Brain-dll/MIDDLE-ALTITUDE-MAIN-SYSTEM-EMBEDDED-/README.md

# technofest-3000-telemetry
This repository was created to improve telemetry system of Ephemeris
