Brain-dll/MIDDLE-ALTITUDE-MAIN-SYSTEM-EMBEDDED-/HARDWARE/Mergen Telemetri + Ateşleme.brd

## EAGLE design HARDWARE/Mergen Telemetri + Ateşleme.brd (2021-08-31)

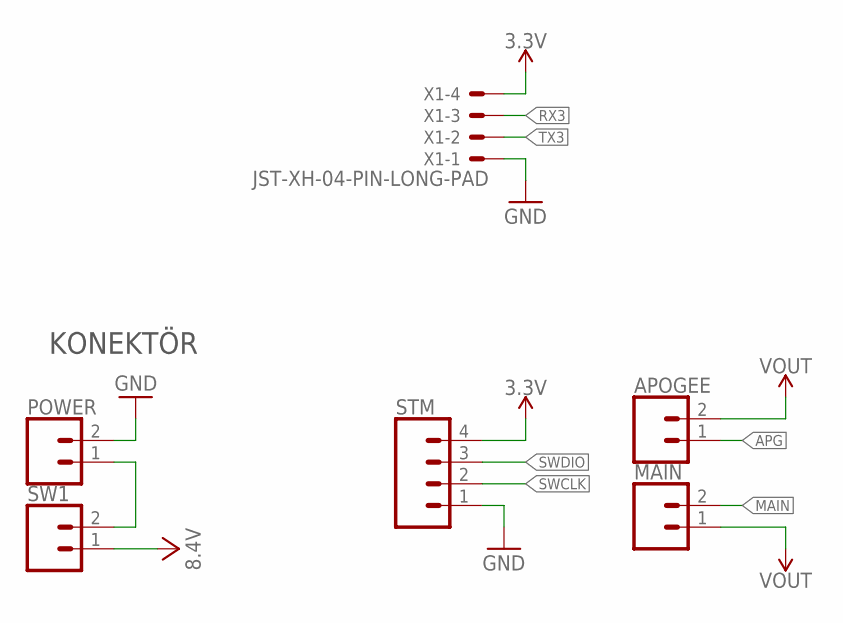
[picture p1: schematic Mergen Telemetri + Ateşleme.sch, sheet 1]

Parts:
APOGEE: CONN_023.5MM-NO_SILK; SCREWTERMINAL-3.5MM-2-NS
MAIN: CONN_023.5MM-NO_SILK; SCREWTERMINAL-3.5MM-2-NS
POWER: CONN_023.5MM-NO_SILK; SCREWTERMINAL-3.5MM-2-NS
STM: CONN_04; 1X04
SW1: CONN_023.5MM-NO_SILK; SCREWTERMINAL-3.5MM-2-NS
X1: JST-XH-04-PIN-LONG-PAD; JST-XH-04-PACKAGE-LONG-PAD

Connections:
3.3V: STM.4, X1.4; also elsewhere on the board
APG: APOGEE.1; also elsewhere on the board
GND: POWER.2, STM.1, X1.1; also elsewhere on the board
MAIN: MAIN.2; also elsewhere on the board
unnamed: POWER.1, SW1.2
RX3: X1.3; also elsewhere on the board
SWCLK: STM.2; also elsewhere on the board
SWDIO: STM.3; also elsewhere on the board
TX3: X1.2; also elsewhere on the board
VCC: SW1.1; also elsewhere on the board
VOUT: APOGEE.2, MAIN.1; also elsewhere on the board

Notes on the sheet:
KONEKTÖR

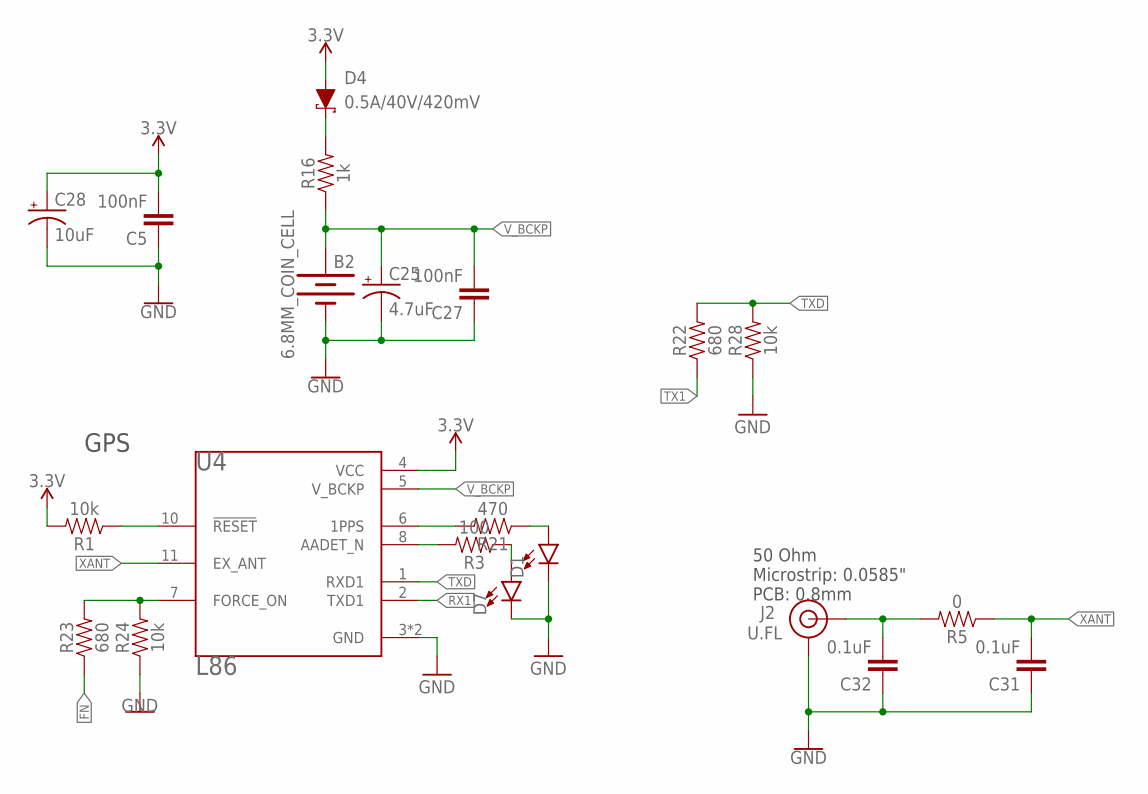
[picture p2: schematic Mergen Telemetri + Ateşleme.sch, sheet 2]

Parts:
B2: 6.8MM_COIN_CELL; BATTCON-6.8MM
C5, C27: 100nF; 0603
C25: 4.7uF; EIA3216
C28: 10uF; EIA3216
C31, C32: 0.1uF; 0603
D1, D7: LED0603; LED-0603
D4: 0.5A/40V/420mV; SOD-323
J2: U.FL
R1, R24, R28: 10k; 0603
R3: 100; 0603
R5: 0; 0603
R16: 1k; 0603
R21: 470; 0603
R22, R23: 680; 0603
U4: L86; XCVR_L86

Connections:
3.3V: C5.2, C28.+, D4.A, R1.2, U4.4 (VCC); also elsewhere on the board
FN: R23.1; also elsewhere on the board
GND: B2.-, C5.1, C25.-, C27.1, C28.-, C31.1, C32.1, D1.C, D7.C, J2.1 (GND), J2.2 (GND), R24.1, R28.1, U4.3 (GND), U4.12 (GND); also elsewhere on the board
unnamed: R1.1, U4.10 (!RESET)
unnamed: R21.2, U4.6 (1PPS)
unnamed: D1.A, R21.1
unnamed: D4.C, R16.2
unnamed: R3.2, U4.8 (AADET_N)
unnamed: D7.A, R3.1
unnamed: C32.2, J2.FEED (SIGNAL), R5.2
unnamed: R23.2, R24.2, U4.7 (FORCE_ON)
RX1: U4.2 (TXD1); also elsewhere on the board
TX1: R22.1; also elsewhere on the board
TXD: R22.2, R28.2, U4.1 (RXD1)
V_BCKP: B2.+, C25.+, C27.2, R16.1, U4.5 (V_BCKP)
XANT: C31.2, R5.1, U4.11 (EX_ANT)

Notes on the sheet:
GPS
50 Ohm Microstrip: 0.0585" PCB: 0.8mm

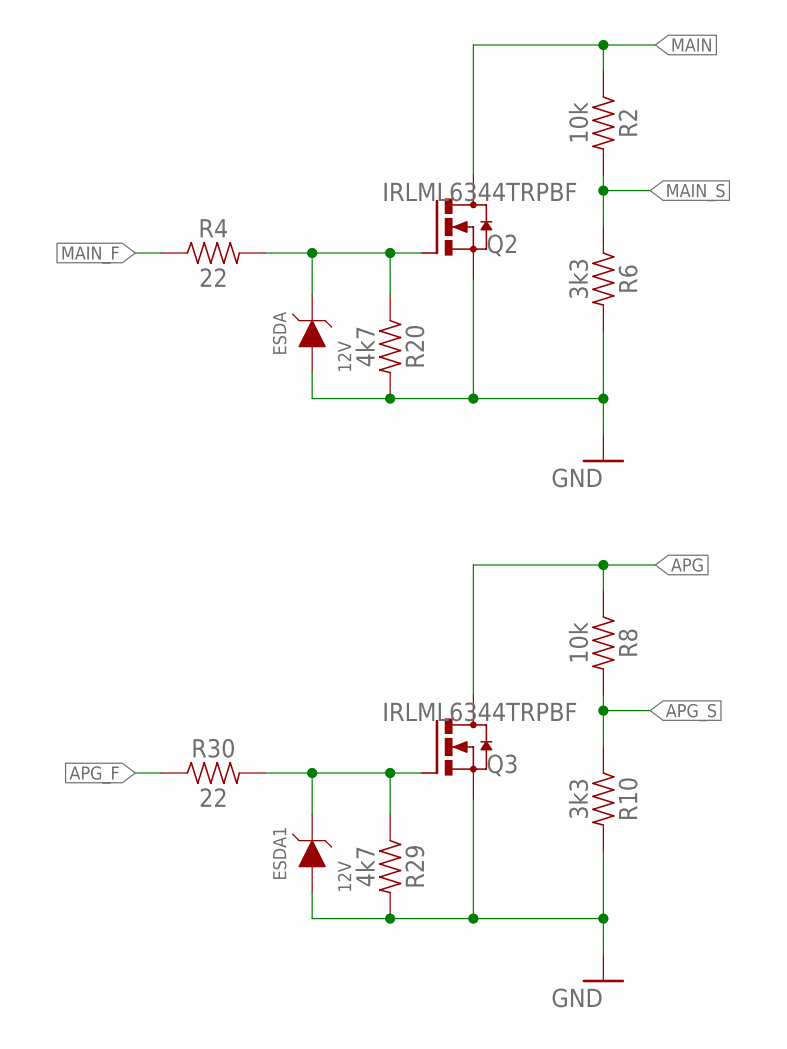
[picture p3: schematic Mergen Telemetri + Ateşleme.sch, sheet 3]

Parts:
ESDA, ESDA1: 12V; WE-TVSP_DO-214AC_UNIDIRECTIONAL
Q2, Q3: IRLML6344TRPBF; SOT23
R2, R8: 10k; 0603
R4, R30: 22; 0603
R6, R10: 3k3; 0603
R20, R29: 4k7; 0603

Connections:
APG: Q3.3 (D), R8.1; also elsewhere on the board
APG_F: R30.1; also elsewhere on the board
APG_S: R8.2, R10.1; also elsewhere on the board
GND: ESDA.2 (A), ESDA1.2 (A), Q2.2 (S), Q3.2 (S), R6.2, R10.2, R20.2, R29.2; also elsewhere on the board
MAIN: Q2.3 (D), R2.1; also elsewhere on the board
MAIN_F: R4.1; also elsewhere on the board
MAIN_S: R2.2, R6.1; also elsewhere on the board
unnamed: ESDA1.1 (C), Q3.1 (G), R29.1, R30.2
unnamed: ESDA.1 (C), Q2.1 (G), R4.2, R20.1

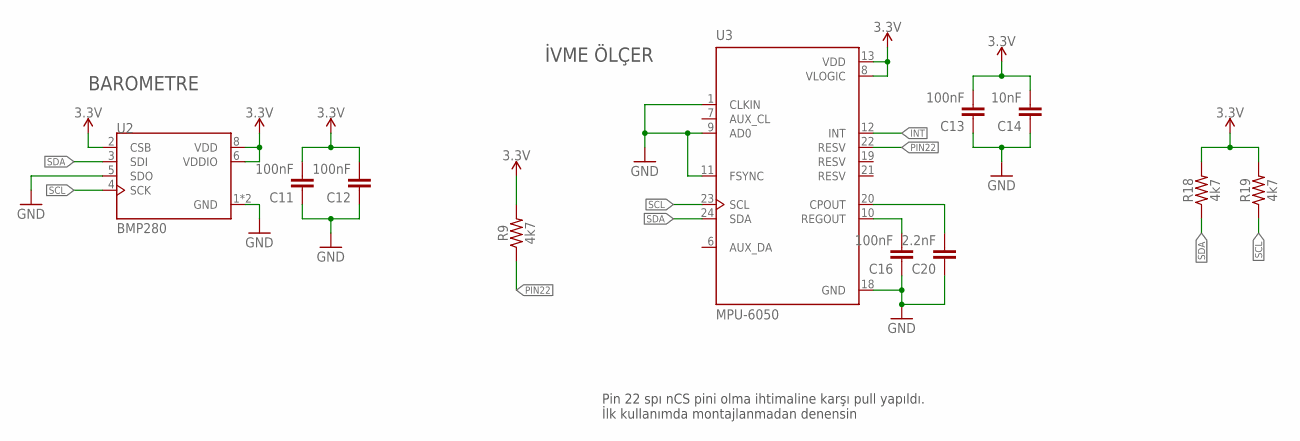
[picture p4: schematic Mergen Telemetri + Ateşleme.sch, sheet 4]

Parts:
C11, C12, C13, C16: 100nF; 0603
C14: 10nF; 0603
C20: 2.2nF; 0603
R9, R18, R19: 4k7; 0603
U2: BMP280; XDCR_BMP280
U3: MPU-6050; QFN50P400X400X95-24N

Connections:
3.3V: C11.2, C12.2, C13.2, C14.2, R9.2, R18.2, R19.2, U2.2 (CSB), U2.6 (VDDIO), U2.8 (VDD), U3.8 (VLOGIC), U3.13 (VDD); also elsewhere on the board
GND: C11.1, C12.1, C13.1, C14.1, C16.1, C20.1, U2.1 (GND), U2.5 (SDO), U2.7 (GND), U3.1 (CLKIN), U3.9 (AD0), U3.11 (FSYNC), U3.18 (GND); also elsewhere on the board
INT: U3.12 (INT); also elsewhere on the board
unnamed: C16.2, U3.10 (REGOUT)
unnamed: C20.2, U3.20 (CPOUT)
PIN22: R9.1, U3.22 (RESV)
SCL: R19.1, U2.4 (SCK), U3.23 (SCL); also elsewhere on the board
SDA: R18.1, U2.3 (SDI), U3.24 (SDA); also elsewhere on the board

Notes on the sheet:
İVME ÖLÇER
BAROMETRE
Pin 22 spı nCS pini olma ihtimaline karşı pull yapıldı. İlk kullanımda montajlanmadan denensin

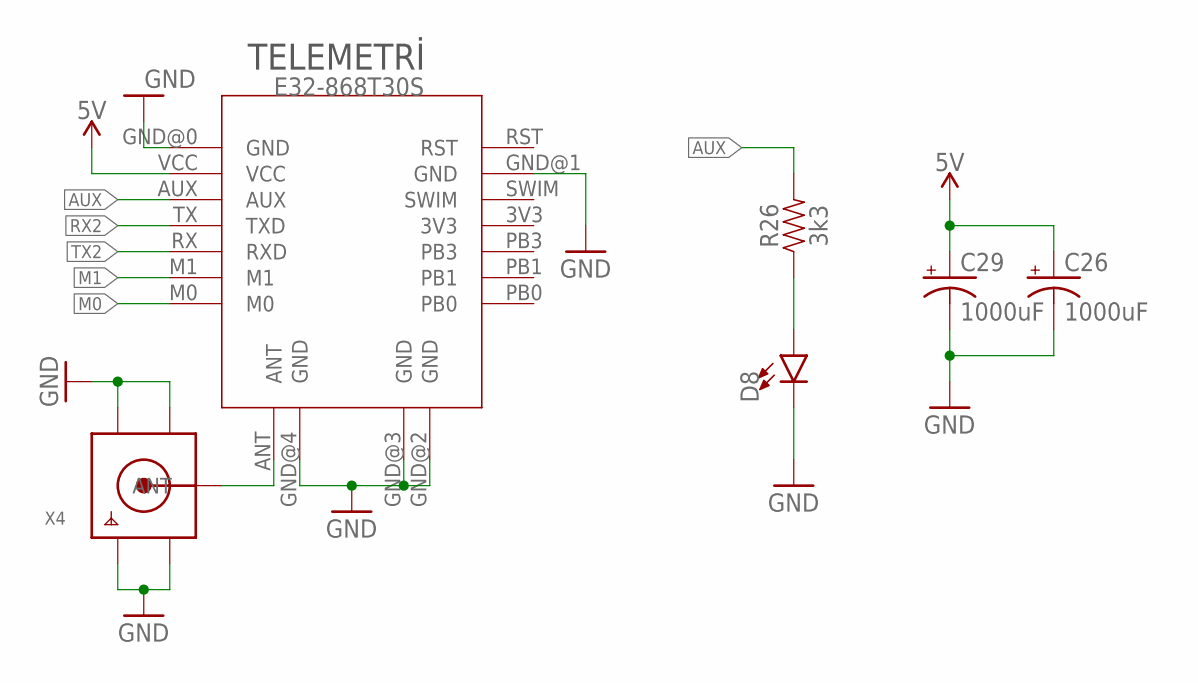
[picture p5: schematic Mergen Telemetri + Ateşleme.sch, sheet 5]

Parts:
C26, C29: 1000uF; 150CLZ-1010
D8: LED0603; LED-0603
R26: 3k3; 0603
U5: E32-868T30S
X4: SMACONNECTOR; SMA90_DIP

Connections:
5V: C26.+, C29.+, U5.VCC; also elsewhere on the board
AUX: R26.2, U5.AUX; also elsewhere on the board
GND: C26.-, C29.-, D8.C, U5.GND@0 (GND), U5.GND@1 (GND), U5.GND@2 (GND), U5.GND@3 (GND), U5.GND@4 (GND), X4.GND1, X4.GND2, X4.GND3, X4.GND4; also elsewhere on the board
M0: U5.M0; also elsewhere on the board
M1: U5.M1; also elsewhere on the board
unnamed: U5.ANT, X4.ANTENNA (ANT)
unnamed: D8.A, R26.1
RX2: U5.TX (TXD); also elsewhere on the board
TX2: U5.RX (RXD); also elsewhere on the board

Notes on the sheet:
TELEMETRİ

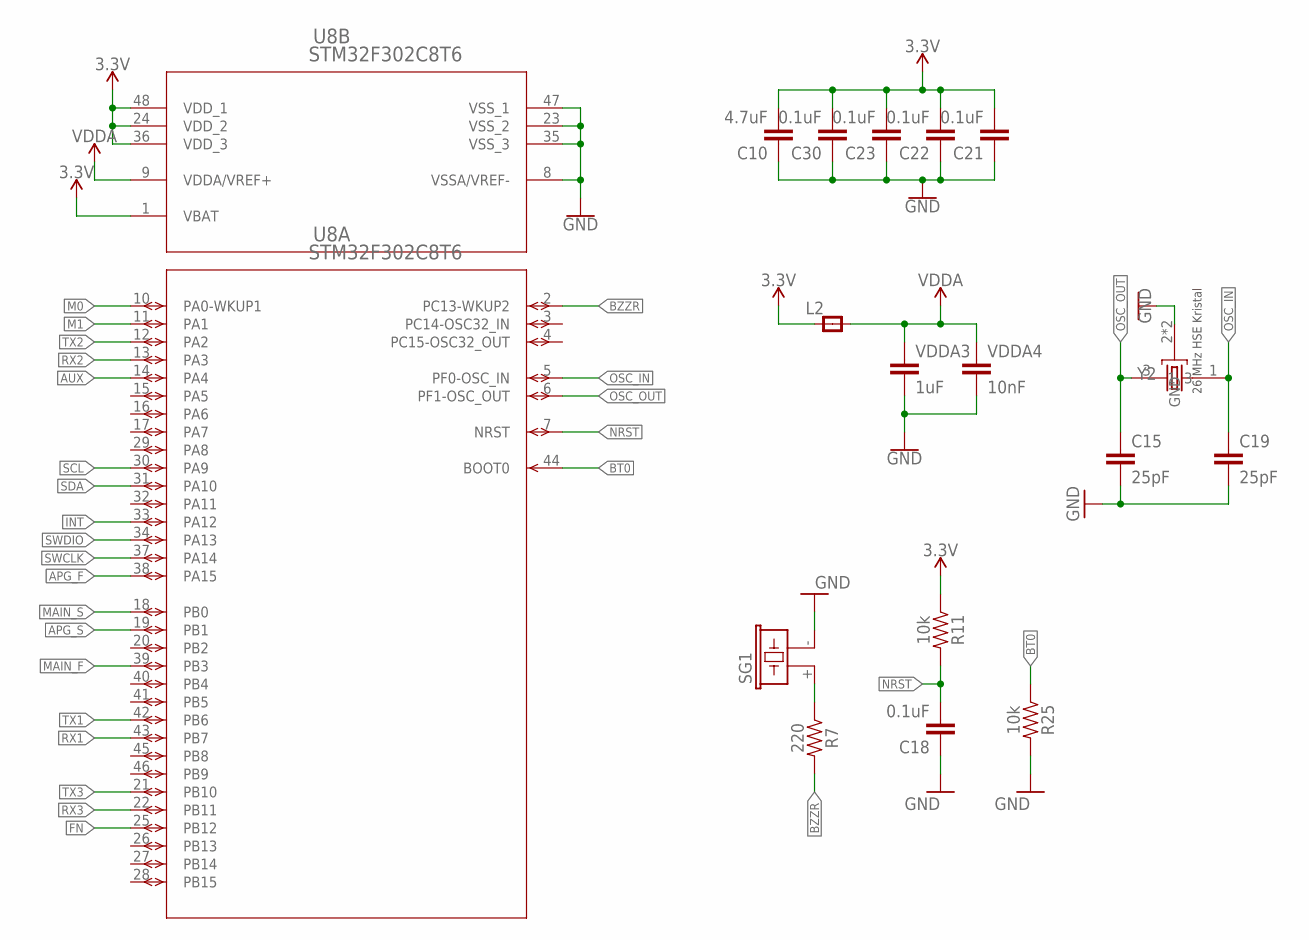
[picture p6: schematic Mergen Telemetri + Ateşleme.sch, sheet 6]

Parts:
C10: 4.7uF; 0603
C15, C19: 25pF; 0603
C18, C21, C22, C23, C30: 0.1uF; 0603
L2: RC-MASTER-SMD_FB_0805MP; RC-MASTER-SMD_L0805MP
R7: 220; 0603
R11, R25: 10k; 0603
SG1: F/CM12P
U8: STM32F302C8T6; LQFP48-7X7MM
VDDA3: 1uF; 0603
VDDA4: 10nF; 0603
Y2: ABM3B-26.000MHZ-10-1-U-T; OSCCC500X320X110-4N

Connections:
3.3V: C10.2, C21.2, C22.2, C23.2, C30.2, L2.1, R11.1, U8.1 (VBAT), U8.24 (VDD_2), U8.36 (VDD_3), U8.48 (VDD_1); also elsewhere on the board
APG_F: U8.38 (PA15); also elsewhere on the board
APG_S: U8.19 (PB1); also elsewhere on the board
AUX: U8.14 (PA4); also elsewhere on the board
BT0: R25.1, U8.44 (BOOT0)
BZZR: R7.2, U8.2 (PC13-WKUP2)
FN: U8.25 (PB12); also elsewhere on the board
GND: C10.1, C15.2, C18.1, C19.2, C21.1, C22.1, C23.1, C30.1, R25.2, SG1.- (2), U8.8 (VSSA/VREF-), U8.23 (VSS_2), U8.35 (VSS_3), U8.47 (VSS_1), VDDA3.2, VDDA4.2, Y2.2 (GND), Y2.4 (GND); also elsewhere on the board
INT: U8.33 (PA12); also elsewhere on the board
M0: U8.10 (PA0-WKUP1); also elsewhere on the board
M1: U8.11 (PA1); also elsewhere on the board
MAIN_F: U8.39 (PB3); also elsewhere on the board
MAIN_S: U8.18 (PB0); also elsewhere on the board
unnamed: R7.1, SG1.+ (1)
NRST: C18.2, R11.2, U8.7 (NRST)
OSC_IN: C19.1, U8.5 (PF0-OSC_IN), Y2.1
OSC_OUT: C15.1, U8.6 (PF1-OSC_OUT), Y2.3
RX1: U8.43 (PB7); also elsewhere on the board
RX2: U8.13 (PA3); also elsewhere on the board
RX3: U8.22 (PB11); also elsewhere on the board
SCL: U8.30 (PA9); also elsewhere on the board
SDA: U8.31 (PA10); also elsewhere on the board
SWCLK: U8.37 (PA14); also elsewhere on the board
SWDIO: U8.34 (PA13); also elsewhere on the board
TX1: U8.42 (PB6); also elsewhere on the board
TX2: U8.12 (PA2); also elsewhere on the board
TX3: U8.21 (PB10); also elsewhere on the board
VDDA: L2.2, U8.9 (VDDA/VREF+), VDDA3.1, VDDA4.1

Notes on the sheet:
26 MHz HSE Kristal

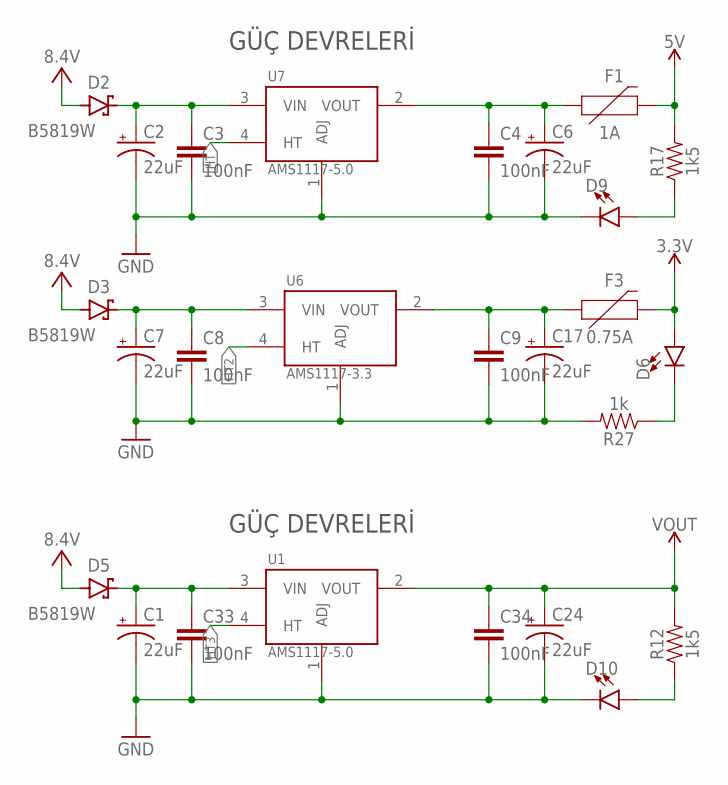
[picture p7: schematic Mergen Telemetri + Ateşleme.sch, sheet 7]

Parts:
C1, C2, C6, C7, C17, C24: 22uF; EIA3528
C3, C4, C8, C9, C33, C34: 100nF; 0603
D2, D3, D5: B5819W; SODFL3718X115
D6, D9, D10: LED0603; LED-0603
F1: 1A; 1206
F3: 0.75A; 1206
R12, R17: 1k5; 0603
R27: 1k; 0603
U1, U7: AMS1117-5.0; SOT229P700X180-4N
U6: AMS1117-3.3; SOT229P700X180-4N

Connections:
3.3V: D6.A, F3.2; also elsewhere on the board
5V: F1.2, R17.2; also elsewhere on the board
GND: C1.C (-), C2.C (-), C3.2, C4.2, C6.C (-), C7.C (-), C8.2, C9.2, C17.C (-), C24.C (-), C33.2, C34.2, D9.C, D10.C, R27.2, U1.1 (ADJ), U6.1 (ADJ), U7.1 (ADJ); also elsewhere on the board
HT: U7.4 (HT)
HT2: U6.4 (HT)
HT3: U1.4 (HT)
unnamed: C2.A (+), C3.1, D2.1 (C), U7.3 (VIN)
unnamed: C7.A (+), C8.1, D3.1 (C), U6.3 (VIN)
unnamed: C4.1, C6.A (+), F1.1, U7.2 (VOUT)
unnamed: C9.1, C17.A (+), F3.1, U6.2 (VOUT)
unnamed: D9.A, R17.1
unnamed: D6.C, R27.1
unnamed: C1.A (+), C33.1, D5.1 (C), U1.3 (VIN)
unnamed: D10.A, R12.1
VCC: D2.2 (A), D3.2 (A), D5.2 (A); also elsewhere on the board
VOUT: C24.A (+), C34.1, R12.2, U1.2 (VOUT); also elsewhere on the board

Notes on the sheet:
GÜÇ DEVRELERİ

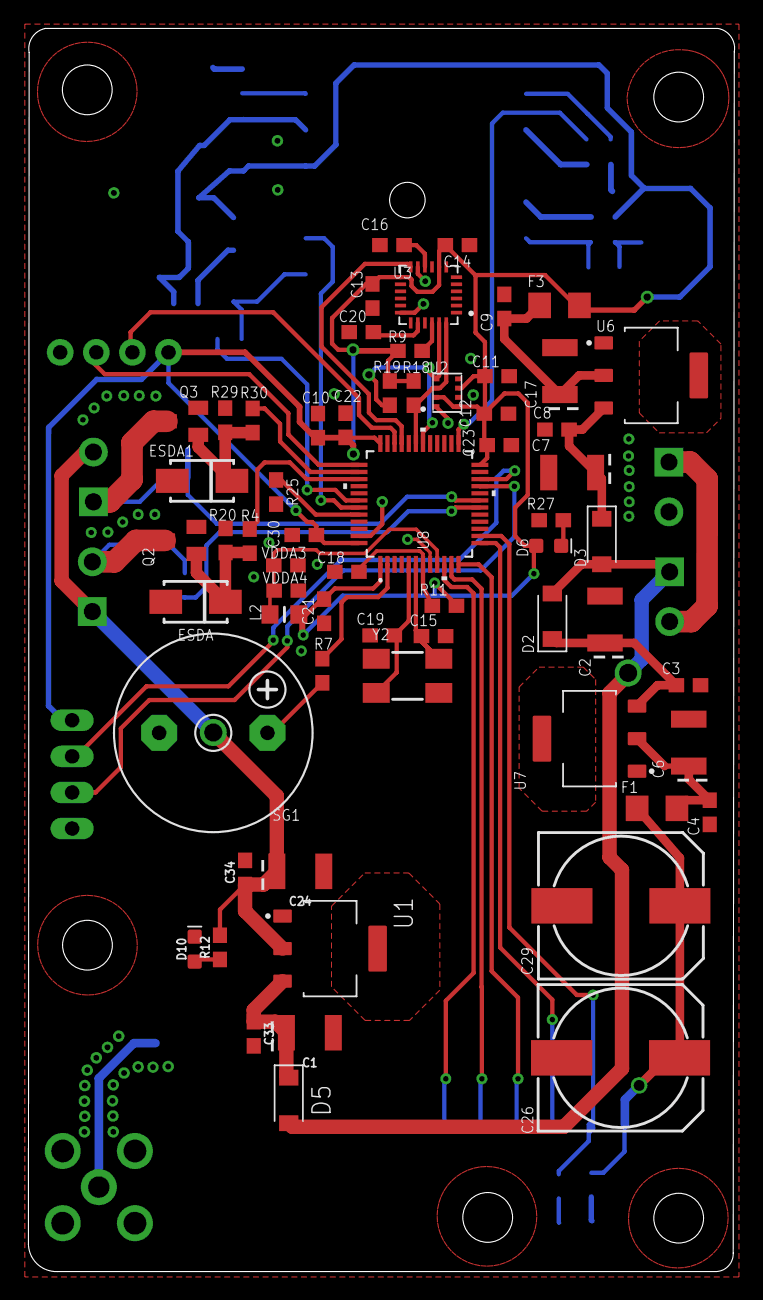
[picture p8: board Mergen Telemetri + Ateşleme.brd from above]

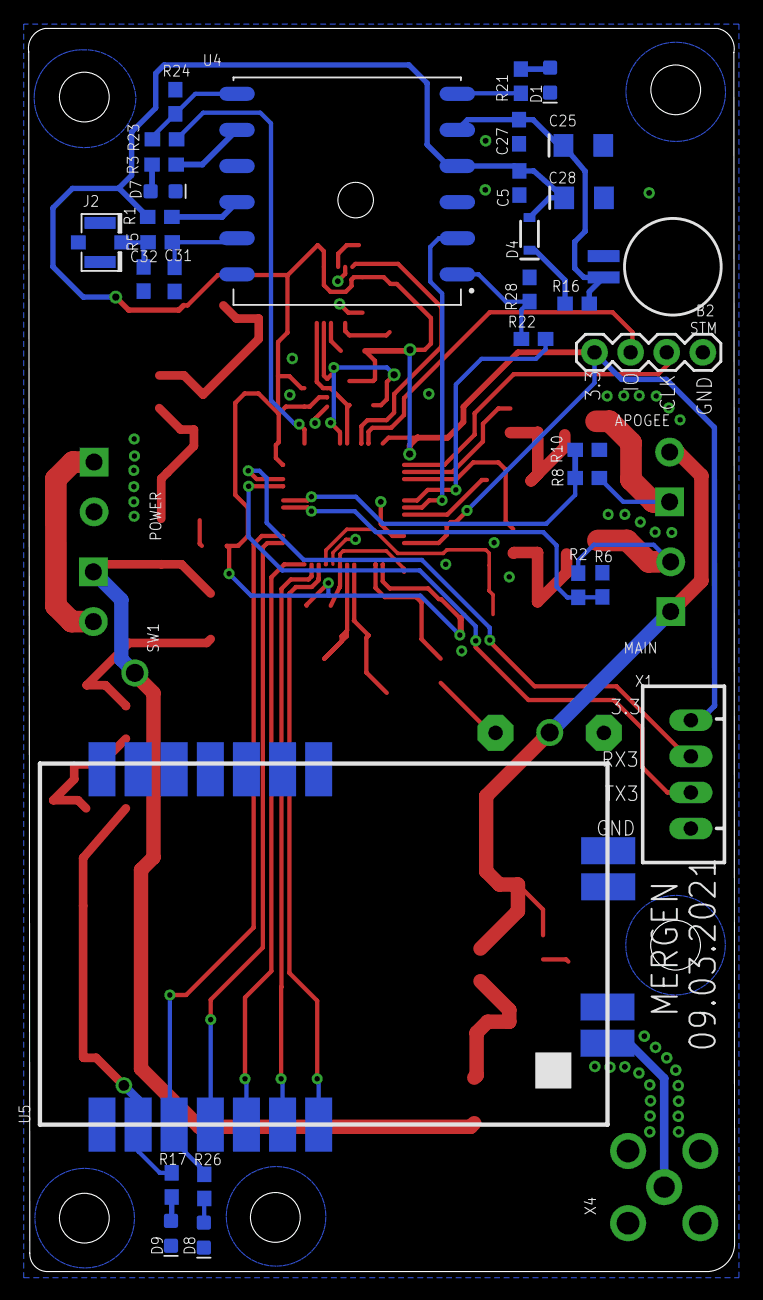
[picture p9: board Mergen Telemetri + Ateşleme.brd from below]

Board: 2 copper layers, 49.7 x 87.5 mm, 99 parts (37 on the bottom side), 60 nets.
