Brain-dll/MIDDLE-ALTITUDE-MAIN-SYSTEM-EMBEDDED-/SOFTWARE/Core/Src/main.c

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
/* Includes ------------------------------------------------------------------*/
#include "main.h"

/* USER CODE BEGIN Includes */
#include "BME280.h"
#include "MPU-6050.h"
#include "math.h"
#include "string.h"
#include "stdio.h"
#include <stdlib.h>
/* USER CODE END Includes */

/* USER CODE BEGIN PD */
#define t 200
#define PI 3.14159265358979323846
#define ACC_l 2.5  // kalkisi anlamak icin gerekli ivme eşigi (pozitif olmali)***

// değişebilir offset değerleri
#define gyroOffsetX -0.22
#define gyroOffsetY  1.11
#define gyroOffsetZ -5.64
#define acceOffsetX  0.38
#define acceOffsetY -1.93

float AcceX = .0, AcceY = .0, AcceZ = .0;
float GyroX = .0, GyroY = .0, GyroZ = .0;
float AcceAngleX = .0, AcceAngleY = .0, GyroAngleX = .0, GyroAngleY = .0, GyroAngleZ = .0;
float GyroBound = 3.0;
float roll = .0, pitch = .0;

float maxPositiveRoll = 0;
float maxNegativeRoll = -79.0;
float maxPositivePitch = 82.0;
float maxNegativePitch = -76.0;


uint32_t CurrentTime = 0, PreviousTime = 0;
float ElapsedTime = .0;

float calcoor(float x);
void LORA_READ_PARAMETER(void);
void LORA_CONFG(uint8_t ADDH, uint8_t ADDL, uint8_t CHN, uint8_t MODE);
void ReadGyroAcceValues(void);
void ReadAccerollpitchValues(void);

float A = 0, T, P, V;
float BM_V[6] = {0}, BM_A[6] = {0};
float MPU_ACC_Z[6] = {0}, roll, pitch, rollFilter, pitchFilter;
float lat;
float lng;

int tim1 = 0, tim2 = 0, dif = 0;
int time = 0;

uint8_t BM_S = 0;
uint8_t apogee = 0, alt_l = 0;
uint8_t MPU_FAIL = 0, MPU = 0, MPU_ACC_S = 0, BME = 0;
uint8_t GGA = 0;
uint8_t k = 0;
uint8_t v = 0;
uint8_t warning = 0;
uint8_t apg = 0;
uint8_t mn = 0;
uint8_t MPU_RP = 0;
uint8_t counter_Tel = 0;
extern uint8_t gyro;

uint8_t runningSize = 5;
float gyroArrayX[5];
float gyroArrayY[5];
float gyroArrayZ[5];
uint8_t countRunning = 1;
float totalGyroX = 0.0;
float totalGyroY = 0.0;
float totalGyroZ = 0.0;
uint8_t startRunning = 0;

uint8_t runningSizeA = 5;
float AcceArrayX[5];
float AcceArrayY[5];
float AcceArrayZ[5];
uint8_t countRunningA = 1;
float totalAcceX = 0.0;
float totalAcceY = 0.0;
float totalAcceZ = 0.0;
uint8_t startRunningA = 0;

char RX_BUF[512];
char GPGGA[75];
char LAT[9];
char LONG[10];
char TIME[10];
char COOR[60];

uint8_t RF = 0;
//uint8_t ADDH = 0x6;
//uint8_t ADDL = 0x4A;
//uint8_t CHN = 0xA;
//uint8_t MODE = 1;

//char LORA_ADRESS[3] = {0};

/*  EPHEMERISH RECEIVER CONFGURATION  */
uint8_t ADDH = 0x8;
uint8_t ADDL = 0x2A;
uint8_t CHN = 0x2;
uint8_t MODE = 1;


/*  EPHEMERISH SENDER CONFGURATION  */
uint8_t SENDER_ADDH = 0x6;
uint8_t SENDER_ADDL = 0x4A;
uint8_t SENDER_CHN = 0xA;


///*  PAYLOAD RECEIVER CONFGURATION  */
//uint8_t ADDH = 0x9;
//uint8_t ADDL = 0x3A;
//uint8_t CHN = 0x3;
//uint8_t MODE = 1;
//
//
///*  PAYLOAD SENDER CONFGURATION  */
//uint8_t SENDER_ADDH = 0x6;
//uint8_t SENDER_ADDL = 0x4A;
//uint8_t SENDER_CHN = 0xA;


/* USER CODE END PD */

I2C_HandleTypeDef hi2c2;

TIM_HandleTypeDef htim1;
TIM_HandleTypeDef htim2;
TIM_HandleTypeDef htim6;
TIM_HandleTypeDef htim15;

UART_HandleTypeDef huart1;
UART_HandleTypeDef huart2;
UART_HandleTypeDef huart3;
DMA_HandleTypeDef hdma_usart1_rx;

/* USER CODE BEGIN PV */
void HAL_UART_RxCpltCallback(UART_HandleTypeDef *huart) {
	for (uint16_t i = 0; i < 512; i++) {

		if (RX_BUF[i] == '$' && RX_BUF[i + 1] == 'G' && RX_BUF[i + 2] == 'P'
				&& RX_BUF[i + 3] == 'G' && RX_BUF[i + 4] == 'G'
				&& RX_BUF[i + 5] == 'A' && RX_BUF[i + 6] == ',') {
			for (uint8_t n = 0; n < sizeof(GPGGA); n++) {
				GPGGA[n] = RX_BUF[i + n];
				if (n > 5 && GPGGA[n - 1] == '\r' && GPGGA[n] == '\n') {
					GGA = 1;
					break;
				}
			}
			if (GGA == 1) {

				uint8_t v = 0, pos1 = 0, pos2 = 0, pos3 = 0, pos4 = 0, pos5 = 0,
						ok1 = 0, ok2 = 0, ok3 = 0, ok4 = 0;
				for (uint8_t n = 0; n < sizeof(GPGGA); n++) {
					if (GPGGA[n] == ',')
						v++;
					if (v == 1 && ok1 == 0) {
						pos1 = n;
						ok1 = 1;
					}
					if (v == 2 && ok2 == 0) {
						pos2 = n;
						for (uint8_t count = 0; count < pos2 - pos1; count++)
							TIME[count] = GPGGA[pos1 + count + 1];
						ok2 = 1;
					}
					if (v == 3 && ok3 == 0) {
						pos3 = n;
						for (uint8_t count = 0; count < pos3 - pos2; count++)
							LAT[count] = GPGGA[pos2 + count + 1];
						ok3 = 1;
					}
					if (v == 4 && ok4 == 0) {
						pos4 = n;
						ok4 = 1;
					}
					if (v == 5) {
						pos5 = n;
						for (uint8_t count2 = 0; count2 < pos5 - pos4; count2++)
							LONG[count2] = GPGGA[pos4 + count2 + 1];

						strcpy(TIME, TIME);
						strcpy(LAT, LAT);
						strcpy(LONG, LONG);
						time = atof(TIME);
						time = time % 100;
						lat = calcoor(atof(LAT));
						lng = calcoor(atof(LONG));
						/*sprintf(COOR, ":%2.7f:%2.7f\n", lat, lng);
						 HAL_UART_Transmit(&huart3, (uint8_t*) COOR,
						 sizeof(COOR), 1000);*/
						for (uint16_t c = 0; c < sizeof(RX_BUF); c++)
							RX_BUF[c] = '\0';
						for (uint16_t c = 0; c < sizeof(GPGGA); c++)
							GPGGA[c] = '\0';
						for (uint16_t c = 0; c < sizeof(LAT); c++)
							LAT[c] = '\0';
						for (uint16_t c = 0; c < sizeof(LONG); c++)
							LONG[c] = '\0';
						for (uint16_t c = 0; c < sizeof(TIME); c++)
							TIME[c] = '\0';
						break;
					}
				}
			}
		}
	}
	//HAL_UART_Receive_DMA(&huart1, (uint8_t *)RX_BUF, 512);
}
/* USER CODE END PV */

void SystemClock_Config(void);
static void MX_GPIO_Init(void);
static void MX_DMA_Init(void);
static void MX_I2C2_Init(void);
static void MX_USART1_UART_Init(void);
static void MX_USART2_UART_Init(void);
static void MX_USART3_UART_Init(void);
static void MX_TIM2_Init(void);
static void MX_TIM6_Init(void);
static void MX_TIM1_Init(void);
static void MX_TIM15_Init(void);
/* USER CODE BEGIN PFP */
//extern uint32_t SystemCoreClock;
//uint32_t Systemlock = 0;
/* USER CODE END PFP */

/**
  * @brief  The application entry point.
  * @retval int
  */
int main(void)
{
  /* MCU Configuration--------------------------------------------------------*/

  /* Reset of all peripherals, Initializes the Flash interface and the Systick. */
   HAL_Init();

  /* Configure the system clock */
  SystemClock_Config();

  /* Initialize all configured peripherals */
  MX_GPIO_Init();
  MX_DMA_Init();
  MX_I2C2_Init();
  MX_USART1_UART_Init();
  MX_USART2_UART_Init();
  MX_USART3_UART_Init();
  MX_TIM2_Init();
  MX_TIM6_Init();
  MX_TIM1_Init();
  MX_TIM15_Init();
  /* USER CODE BEGIN 2 */
	/*HAL_GPIO_WritePin(GPIOA, GPIO_PIN_0, SET);
	HAL_GPIO_WritePin(GPIOA, GPIO_PIN_1, SET);*/
	LORA_READ_PARAMETER();  // don't make commit all of these two functions
	LORA_CONFG(0x6, 0x4A, 0xA, 1);   // HIGH ADDRESS, LOW ADDRESS, CHANNEL, MODE (0 : TRANSPARENT, 1 : FIXED)

	BME280_Init();
	MPU6050_Init();

	enum device {
		Ephemerish, Payload
	} dev_ID;
	dev_ID = Ephemerish;
	//dev_ID = Payload;

	enum rocket {
		Rail, Launch, Burnout, Apogee, Descent, Main, Recovery
	};
	enum rocket EPHEMERISH;

	for (uint8_t i = 0; i < 12; i++) {
		HAL_GPIO_TogglePin(GPIOC, GPIO_PIN_13);
		HAL_Delay(50);
	}
	HAL_TIM_Base_Start_IT(&htim2);
	if (MPU_FAIL == 0) {
		EPHEMERISH = Rail;
		//EPHEMERISH = Apogee;
		HAL_TIM_Base_Start_IT(&htim6);
	} else if (MPU_FAIL == 1) {
		EPHEMERISH = Launch;

	}
	HAL_TIM_Base_Start(&htim15);
	HAL_TIM_Base_Start(&htim1);
	HAL_TIM_Base_Start_IT(&htim2);
	//  *************
	__HAL_UART_ENABLE_IT(&huart1, UART_IT_IDLE);
	HAL_UART_Receive_DMA(&huart1, (uint8_t *)RX_BUF, 512);
	//  ************
  /* USER CODE END 2 */

  /* Infinite loop */
  /* USER CODE BEGIN WHILE */
  while (1)
  {
    /* USER CODE END WHILE */

		/* USER CODE BEGIN 3 */

//		tim1 = __HAL_TIM_GET_COUNTER(&htim1);
//		BM_A[0] = BME280_ALT_MEDIANFILTER();
//		tim2 = __HAL_TIM_GET_COUNTER(&htim1);
//		if (tim2 < tim1) {
//			tim2 = tim2 + 65535;
//			dif = tim2 - tim1;
//		} else
//			dif = tim2 - tim1;


		if (EPHEMERISH != Rail) {
			ReadAccerollpitchValues();
		}

		switch (EPHEMERISH) {
		case Rail:
			if (MPU == 1) {
				MPU_ACC_Z[MPU_ACC_S] = MEDIAN_AXIS_FILTER('A', 'Z');
				if (MPU_ACC_S == 5) {
					uint8_t C1 = 0;
					for (uint8_t i = 0; i <= MPU_ACC_S; i++) {
						if (MPU_ACC_Z[i] < (-1 * ACC_l) || MPU_ACC_Z[i] > ACC_l)
							C1++;
					}
					if (C1 >= 3) {
						EPHEMERISH = Launch;
						//EPHEMERISH = Apogee;
						for (uint8_t i = 0; i < (EPHEMERISH * 2); i++) {
							HAL_GPIO_TogglePin(GPIOC, GPIO_PIN_13);
							HAL_Delay(50);
						}
						HAL_TIM_Base_Start(&htim1);
					}
					MPU_ACC_S = 0;
				}
				MPU_ACC_S++;
				MPU = 0;
			}
			break;
		case Launch:
			if (BME == 1) {
				if (alt_l == 0) {
					tim1 = __HAL_TIM_GET_COUNTER(&htim1);
					BM_A[0] = BME280_ALT_MEDIANFILTER();
					alt_l = 1;
				} else if (alt_l == 1) {
					tim2 = __HAL_TIM_GET_COUNTER(&htim1);
					BM_A[1] = BME280_ALT_MEDIANFILTER();
					if (tim2 < tim1) {
						tim2 = tim2 + 65535;
						dif = tim2 - tim1;
					} else
						dif = tim2 - tim1;
					BM_V[BM_S] = (BM_A[1] - BM_A[0]) / (0.001 * dif);
					if (BM_S == 5) {
						uint8_t M = 0;
						for (uint8_t i = 0; i <= BM_S; i++) {
							if (BM_V[i] > 35) // TEST BURNOUT VALUE = 15 READ BURNOUT VALUE = 100
								M++;
						}
						if (M >= 4) {
							//**********************
							EPHEMERISH = Burnout;

							for (uint8_t i = 0; i < (EPHEMERISH * 2); i++) {
								HAL_GPIO_TogglePin(GPIOA, GPIO_PIN_3);
								HAL_Delay(50);
							}
						}
						for (uint8_t k = 0; k <= 5; k++)
							BM_V[k] = 0;
						BM_S = 0;
					}
					BM_S++;
					alt_l = 0;
				}
				BME = 0;
			}
			break;
		case Burnout:
			if (BME == 1) {
				if (alt_l == 0) {
					tim1 = __HAL_TIM_GET_COUNTER(&htim1);
					BM_A[0] = BME280_ALT_MEDIANFILTER();
					alt_l = 1;
				} else if (alt_l == 1) {
					tim2 = __HAL_TIM_GET_COUNTER(&htim1);
					BM_A[1] = BME280_ALT_MEDIANFILTER();
					if (tim2 < tim1) {
						tim2 = tim2 + 65535;
						dif = tim2 - tim1;
					} else
						dif = tim2 - tim1;
					BM_V[BM_S] = (BM_A[1] - BM_A[0]) / (0.001 * dif);
					if (BM_S == 5) {
						uint8_t M = 0;
						for (uint8_t i = 0; i <= BM_S; i++) {
							if (BM_V[i] < 5)    //  if (BM_V[i] < 20)
								M++;
						}
						if (M >= 4) {
							EPHEMERISH = Apogee;
							HAL_TIM_Base_Stop_IT(&htim2);
							tim1 = __HAL_TIM_GET_COUNTER(&htim1);
							for (uint8_t i = 0; i < (EPHEMERISH * 2); i++) {
								HAL_GPIO_TogglePin(GPIOC, GPIO_PIN_13);
								HAL_Delay(50);
							}
						}
						for (uint8_t k = 0; k <= 5; k++)
							BM_V[k] = 0;
						BM_S = 0;
					}
					BM_S++;
					alt_l = 0;
				}
				BME = 0;
			}
			break;
		case Apogee:
			//EPHEMERISH = Recovery;
			/******  GYRO ALGORITHM  ******/
			tim2 = __HAL_TIM_GET_COUNTER(&htim1);
			if (tim2 < tim1) {
				tim2 = tim2 + 65535;
				dif = tim2 - tim1;
			} else
				dif = tim2 - tim1;
			ReadGyroAcceValues();

			if (abs(roll) > 40 || abs(pitch) > 40 || dif > 2000) {  // ****************
				EPHEMERISH = Descent;
				for (uint8_t i = 0; i < (EPHEMERISH * 2); i++) {
					HAL_GPIO_TogglePin(GPIOC, GPIO_PIN_13);
					HAL_Delay(50);
				}
				HAL_GPIO_TogglePin(GPIOC, GPIO_PIN_13);
				HAL_GPIO_WritePin(GPIOA, GPIO_PIN_15, SET);
				HAL_Delay(600);
				HAL_GPIO_WritePin(GPIOA, GPIO_PIN_15, RESET);
				HAL_GPIO_TogglePin(GPIOC, GPIO_PIN_13);
				apg = 1;
				HAL_TIM_Base_Start_IT(&htim2);
			}
			break;
		case Descent:
			if (BME == 1) {

				if (alt_l == 0) {
					tim1 = __HAL_TIM_GET_COUNTER(&htim1);
					BM_A[0] = BME280_ALT_MEDIANFILTER();
					alt_l = 1;
				} else if (alt_l == 1) {
					tim2 = __HAL_TIM_GET_COUNTER(&htim1);
					BM_A[1] = BME280_ALT_MEDIANFILTER();
					if (tim2 < tim1) {
						tim2 = tim2 + 65535;
						dif = tim2 - tim1;
					} else
						dif = tim2 - tim1;
					BM_V[BM_S] = (BM_A[1] - BM_A[0]) / (0.001 * dif);
					alt_l = 0;  //**************
				}

				BM_A[BM_S] = BME280_ALT_MEDIANFILTER();
				if (BM_S == 5) {
					uint8_t M = 0;
					for (uint8_t i = 0; i <= BM_S; i++) {
						if (BM_A[i] < 500)
							M++;
					}
					if (M >= 3) {
						// MAIN FIRE
						EPHEMERISH = Main;
						for (uint8_t i = 0; i < (EPHEMERISH * 2); i++) {
							HAL_GPIO_TogglePin(GPIOC, GPIO_PIN_13);
							HAL_Delay(50);
						}
					}
					for (uint8_t k = 0; k <= 5; k++)
						BM_A[k] = 0;
					BM_S = 0;
				}
				BM_S++;
				BME = 0;
			}
			break;
		case Main:
			EPHEMERISH = Recovery;
			for (uint8_t i = 0; i < (EPHEMERISH * 2); i++) {
				HAL_GPIO_TogglePin(GPIOC, GPIO_PIN_13);
				HAL_Delay(50);
			}
			HAL_GPIO_WritePin(GPIOC, GPIO_PIN_13, SET);
			HAL_GPIO_WritePin(GPIOB, GPIO_PIN_3, SET);
			HAL_Delay(600);
			HAL_GPIO_WritePin(GPIOB, GPIO_PIN_3, RESET);
			HAL_GPIO_WritePin(GPIOC, GPIO_PIN_13, RESET);
			mn = 1;
			break;
		case Recovery:
			if (BME == 1) {
				if (alt_l == 0) {
					tim1 = __HAL_TIM_GET_COUNTER(&htim1);
					BM_A[0] = BME280_ALT_MEDIANFILTER();
					alt_l = 1;
				} else if (alt_l == 1) {
					tim2 = __HAL_TIM_GET_COUNTER(&htim1);
					BM_A[1] = BME280_ALT_MEDIANFILTER();
					if (tim2 < tim1) {
						tim2 = tim2 + 65535;
						dif = tim2 - tim1;
					} else
						dif = tim2 - tim1;
					BM_V[BM_S] = (BM_A[1] - BM_A[0]) / (0.001 * dif);
					alt_l = 0;  //**************
					BM_S++;
					if (BM_S == 5)
						BM_S = 0;
				}
			}
			if (warning == 1) {
				HAL_GPIO_TogglePin(GPIOC, GPIO_PIN_13);
				HAL_Delay(50);
				HAL_GPIO_TogglePin(GPIOC, GPIO_PIN_13);
				warning = 0;
			}
			break;
		}
		if (RF == 1 && ((time % 6) == 0 || (time % 6) == 1))  	// EPHEMERISH
		//if(RF == 1 && ((time % 6) == 3 || (time % 6) == 4))	// PAYLOAD
				{
//			LORA_ADRESS[0] = SENDER_ADDH;
//			LORA_ADRESS[1] = SENDER_ADDL;
//			LORA_ADRESS[2] = SENDER_CHN;
//
//			sprintf(LORA_ADRESS, "%s", LORA_ADRESS);

			if (EPHEMERISH == Rail && counter_Tel < 10) {
				COOR[0] = SENDER_ADDH;
				COOR[1] = SENDER_ADDL;
				COOR[2] = SENDER_CHN;

				sprintf(COOR, "%s%d:%d:%2.7f:%2.7f:%.2f:%.2f:%.2f,%.2f:%d:%d\n",
						COOR, dev_ID, time, lat, lng, BM_A[1], BM_V[2], roll,
						pitch, apg, mn);

//				sprintf(COOR, "%s%d:%d:%2.7f:%2.7f:%.2f:%.2f:%.2f,%.2f:%d:%d\n",
//						LORA_ADRESS, dev_ID, time, lat, lng, BM_A[1], BM_V[2], roll,
//						pitch, apg, mn);
				HAL_UART_Transmit(&huart2, (uint8_t*) COOR, sizeof(COOR), 1000);
				for (uint16_t X = 0; X < sizeof(COOR); X++) {
					COOR[X] = '\0';
				}
				counter_Tel++;
			} else if (EPHEMERISH != Rail) {
				COOR[0] = SENDER_ADDH;
				COOR[1] = SENDER_ADDL;
				COOR[2] = SENDER_CHN;
				sprintf(COOR, "%s%d:%d:%2.7f:%2.7f:%.2f:%.2f:%.2f,%.2f:%d:%d\n",
						COOR, dev_ID, time, lat, lng, BM_A[1], BM_V[2],
						AcceAngleX, AcceAngleY, apg, mn);

//				sprintf(COOR, "%s%d:%d:%2.7f:%2.7f:%.2f:%.2f:%.2f,%.2f:%d:%d\n",
//						LORA_ADRESS, dev_ID, time, lat, lng, BM_A[1], BM_V[2],
//						roll, pitch, apg, mn);
				HAL_UART_Transmit(&huart2, (uint8_t*) COOR, sizeof(COOR), 1000);
				for (uint16_t X = 0; X < sizeof(COOR); X++) {
					COOR[X] = '\0';
				}
			}
			lat = .0;
			lng = .0;
			RF = 0;
		}
	}

  /* USER CODE END 3 */
}

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
/* USER CODE BEGIN 4 */
void LORA_CONFG(uint8_t ADDH, uint8_t ADDL, uint8_t CHN, uint8_t MODE)
{
	HAL_GPIO_WritePin(GPIOA, GPIO_PIN_0, SET);
	HAL_GPIO_WritePin(GPIOA, GPIO_PIN_1, SET);
	HAL_Delay(50);

	char cfg_buff[6] = {0};
	enum lora{Transparent, Fixed} mode;
	mode = MODE;

	cfg_buff[0] = 0xC0;  // header for saving paramater when power down C0
	cfg_buff[1] = ADDH;  // high address
	cfg_buff[2] = ADDL;  // low address
	cfg_buff[3] = 0x19;  // SPED (parity, baud, data rate)  1.2 kbps air data rate
	cfg_buff[4] = CHN;   // channel

	switch(mode){
	case Transparent:
		cfg_buff[5] = 0x44;  // option
		break;
	case Fixed:
		cfg_buff[5] = 0xC4;  // option
		break;
	default:
		cfg_buff[5] = 0x44;  // option
	}

	HAL_UART_Transmit(&huart2, (uint8_t*) cfg_buff, 6, 1000);

	HAL_Delay(25);
	HAL_GPIO_WritePin(GPIOA, GPIO_PIN_0, RESET);
	HAL_GPIO_WritePin(GPIOA, GPIO_PIN_1, RESET);
	HAL_Delay(25);
}

void LORA_READ_PARAMETER()
{
	HAL_GPIO_WritePin(GPIOA, GPIO_PIN_0, SET);
	HAL_GPIO_WritePin(GPIOA, GPIO_PIN_1, SET);
	HAL_Delay(50);

	char buff_read[6] = {0};
	buff_read[0] = 0xC1;
	buff_read[1] = 0xC1;
	buff_read[2] = 0xC1;

	HAL_UART_Transmit(&huart2, (uint8_t*) buff_read, 3, 1000);
	HAL_UART_Receive(&huart2, (uint8_t*) buff_read, 6, 1000);

	HAL_Delay(25);
	HAL_GPIO_WritePin(GPIOA, GPIO_PIN_0, RESET);
	HAL_GPIO_WritePin(GPIOA, GPIO_PIN_1, RESET);
	HAL_Delay(25);
}

float calcoor(float x)
{
	float a = (int)x / 100;
	float b = (x - (a * 100.0)) / 60.0;
	return a+b;
}

void ReadGyroAcceValues() {

	PreviousTime = CurrentTime;
	CurrentTime = __HAL_TIM_GET_COUNTER(&htim15);
	if (CurrentTime < PreviousTime)
		CurrentTime += 65535;
	ElapsedTime = (float) (CurrentTime - PreviousTime) / 1000.0;

	AcceX = MPU6050_AccX();
	AcceY = MPU6050_AccY();
	AcceZ = MPU6050_AccZ();

	AcceAngleX = ((atan((AcceY) / sqrt(pow((AcceX), 2) + pow((AcceZ), 2))) * 180
			/ PI)) - acceOffsetX;
	AcceAngleY = ((atan(-1 * (AcceX) / sqrt(pow((AcceY), 2) + pow((AcceZ), 2)))
			* 180 / PI)) - acceOffsetY;

	GyroX = MPU6050_GyroX();
	GyroY = MPU6050_GyroY();
	GyroZ = MPU6050_GyroZ();

	// handle gyro errors
	GyroX = GyroX - gyroOffsetX;
	GyroY = GyroY - gyroOffsetY;
	GyroZ = GyroZ - gyroOffsetZ;

	if (abs(GyroX) < GyroBound) {
		GyroX = 0;
	}
	if (abs(GyroY) < GyroBound) {
		GyroY = 0;
	}
	if (abs(GyroZ) < GyroBound + 3) {
		GyroZ = 0;
	}

	if (countRunning >= runningSize && startRunning == 0) {
		startRunning = 1;
	}

	totalGyroX += (-gyroArrayX[countRunning - 1] + GyroX);
	totalGyroY += (-gyroArrayY[countRunning - 1] + GyroY);
	totalGyroZ += (-gyroArrayZ[countRunning - 1] + GyroZ);
	gyroArrayX[countRunning - 1] = GyroX;
	gyroArrayY[countRunning - 1] = GyroY;
	gyroArrayZ[countRunning - 1] = GyroZ;

	// take average
	if (startRunning) {
		GyroX = (totalGyroX / (float) runningSize);
		GyroY = (totalGyroY / (float) runningSize);
		GyroZ = (totalGyroZ / (float) runningSize);
	}

	countRunning++;
	if (countRunning >= (runningSize + 1)) {
		countRunning = 1;
	}

	GyroAngleX += (GyroX * ElapsedTime);
	GyroAngleY += (GyroY * ElapsedTime);

//	if (gyro == 1) {
//		GyroAngleX = AcceAngleX;
//		GyroAngleY = AcceAngleY;
//		gyro = 0;
//	}

	roll = 0.90 * GyroAngleX + 0.10 * AcceAngleX;
	pitch = 0.90 * GyroAngleY + 0.10 * AcceAngleY;

	MPU_RP = 0;

}

void ReadAccerollpitchValues(void) {

//	PreviousTime = CurrentTime;
//	CurrentTime = __HAL_TIM_GET_COUNTER(&htim15);
//	if (CurrentTime < PreviousTime)
//		CurrentTime += 65535;
//	ElapsedTime = (float) (CurrentTime - PreviousTime) / 1000.0;

	AcceX = MPU6050_AccX();
	AcceY = MPU6050_AccY();
	AcceZ = MPU6050_AccZ();

	if (countRunningA >= runningSizeA && startRunningA == 0) {
		startRunningA = 1;
	}

	totalAcceX += (-AcceArrayX[countRunningA - 1] + AcceX);
	totalAcceY += (-AcceArrayY[countRunningA - 1] + AcceY);
	totalAcceZ += (-AcceArrayZ[countRunningA - 1] + AcceZ);
	AcceArrayX[countRunningA - 1] = AcceX;
	AcceArrayY[countRunningA - 1] = AcceY;
	AcceArrayZ[countRunningA - 1] = AcceZ;

	// take average
	if (startRunning) {
		AcceX = (totalAcceX / (float) runningSizeA);
		AcceY = (totalAcceY / (float) runningSizeA);
		AcceZ = (totalAcceZ / (float) runningSizeA);
	}

	countRunningA++;
	if (countRunningA >= (runningSizeA + 1)) {
		countRunningA = 1;
	}

	AcceAngleX = ((atan((AcceY) / sqrt(pow((AcceX), 2) + pow((AcceZ), 2))) * 180
			/ PI)) - acceOffsetX;
	AcceAngleY = ((atan(-1 * (AcceX) / sqrt(pow((AcceY), 2) + pow((AcceZ), 2)))
			* 180 / PI)) - acceOffsetY;

//	GyroX = MPU6050_GyroX();
//	GyroY = MPU6050_GyroY();
//	GyroZ = MPU6050_GyroZ();
//
//	// handle gyro errors
//	GyroX = GyroX - gyroOffsetX;
//	GyroY = GyroY - gyroOffsetY;
//	GyroZ = GyroZ - gyroOffsetZ;

//	if (abs(GyroX) < GyroBound) {
//		GyroX = 0;
//	}
//	if (abs(GyroY) < GyroBound) {
//		GyroY = 0;
//	}
//	if (abs(GyroZ) < GyroBound + 3) {
//		GyroZ = 0;
//	}


//
//	GyroAngleX += (GyroX * ElapsedTime);
//	GyroAngleY += (GyroY * ElapsedTime);

//	if (gyro == 1) {
//		GyroAngleX = AcceAngleX;
//		GyroAngleY = AcceAngleY;
//		gyro = 0;
//	}

//	roll = 0.90 * GyroAngleX + 0.10 * AcceAngleX;
//	pitch = 0.90 * GyroAngleY + 0.10 * AcceAngleY;

	MPU_RP = 0;

}
/* USER CODE END 4 */
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
