Brain-dll/MIDDLE-ALTITUDE-MAIN-SYSTEM-EMBEDDED-/SOFTWARE/MAIN_AVIONIC.ioc

Mcu.UserName=STM32F302C8Tx
PA0.GPIO_Label=M0
PA0.Signal=GPIO_Output
PA1.GPIO_Label=M1
PA1.Signal=GPIO_Output
PA10.Signal=I2C2_SDA
PA13.Signal=SYS_JTMS-SWDIO
PA14.Signal=SYS_JTCK-SWCLK
PA15.GPIO_Label=APOGEE
PA15.Signal=GPIO_Output
PA2.Signal=USART2_TX
PA3.Signal=USART2_RX
PA9.Signal=I2C2_SCL
PB10.Signal=USART3_TX
PB11.Signal=USART3_RX
PB3.GPIO_Label=MAIN
PB3.Signal=GPIO_Output
PB6.Signal=USART1_TX
PB7.Signal=USART1_RX
PC13.GPIO_Label=BUZZER
PC13.Signal=GPIO_Output
PF0-OSC_IN.Signal=RCC_OSC_IN
PF1-OSC_OUT.Signal=RCC_OSC_OUT
