Brain-dll/MIDDLE-ALTITUDE-MAIN-SYSTEM-EMBEDDED-/SOFTWARE/Core/Inc/main.h

#define BUZZER_Pin GPIO_PIN_13
#define BUZZER_GPIO_Port GPIOC
#define M0_Pin GPIO_PIN_0
#define M0_GPIO_Port GPIOA
#define M1_Pin GPIO_PIN_1
#define M1_GPIO_Port GPIOA
#define APOGEE_Pin GPIO_PIN_15
#define APOGEE_GPIO_Port GPIOA
#define MAIN_Pin GPIO_PIN_3
#define MAIN_GPIO_Port GPIOB
