Brain-dll/MIDDLE-ALTITUDE-MAIN-SYSTEM-EMBEDDED-/(commit log)

2021-03-08 Telemetry V1.0.0 was completed
    [Mergen Telemetri + Ateşleme.brd, Mergen Telemetri + Ateşleme.sch]
2021-03-08 Some modification was maken on the LPS22HB and ADXL345
    [Mergen Telemetri + Ateşleme.brd, Mergen Telemetri + Ateşleme.sch]
2021-03-10 Routes were be extended
    [Mergen Telemetri + Ateşleme.brd, Mergen Telemetri + Ateşleme.sch]
2021-03-10 LOGO was uploaded
    [Mergen Telemetri + Ateşleme.brd, Mergen Telemetri + Ateşleme.sch]
2021-03-14 Extra polygon was added for methal distance and 1x4 JST connector was added for payload
    [Mergen Telemetri + Ateşleme.brd, Mergen Telemetri + Ateşleme.sch]
2021-03-24 System was redesigned with new controller and sensors
    [Adafruit BMP280 STEMMA QT.brd, Adafruit BMP280 STEMMA QT.sch, Adafruit BMP280.brd, Adafruit BMP280.sch, Grove - Barometer Sensor (BMP280) v1.0.brd, Grove - Barometer Sensor (BMP280) v1.0.sch, Mergen Telemetri + Ateşleme.brd, Mergen Telemetri + Ateşleme.sch]
2021-03-26 New version of boards with new controller was designed
    [LQFP48-7x7mm.step, Mergen Telemetri + Ateşleme.brd, Mergen Telemetri + Ateşleme.sch]
2021-03-28 Connector was changed and Preparing first order
    [Mergen Telemetri + Ateşleme.brd, Mergen Telemetri + Ateşleme.sch]
2021-04-03 Polygon witdh was increased IMPORTANT
    [Mergen Telemetri + Ateşleme.brd, Mergen Telemetri + Ateşleme.sch]
2021-04-03 Polygon 15 mils
    [Mergen Telemetri + Ateşleme.brd]
2021-04-06 NMOS trace was be expanded and creating 1206 package version was tried
    [Mergen Telemetri + Ateşleme.brd, Mergen Telemetri + Ateşleme.sch]
2021-04-08 packages was modified according to stock situation
    [Mergen Telemetri + Ateşleme.brd, Mergen Telemetri + Ateşleme.sch]
2021-04-19 Some modification was done
    [Mergen Telemetri + Ateşleme.brd]
2021-05-03 Component name locations was arranged
    [Mergen Telemetri + Ateşleme.brd]
2021-06-02 Update was unsuccesfull
    [Mergen Telemetri + Ateşleme.brd, Mergen Telemetri + Ateşleme.sch]
2021-06-30 Documents were redesigned and VDDA cap value was cganed
    [LQFP48-7x7mm.step, Mergen Telemetri + Ateşleme.brd, Mergen Telemetri + Ateşleme.sch]
2021-07-05 5V lineer regülator was added for ignition outputs
    [Mergen Telemetri + Ateşleme.brd, Mergen Telemetri + Ateşleme.sch]
2021-07-05 Regulator was added for e match
    [Mergen Telemetri + Ateşleme.brd]
2021-07-07 Regulator name was changed as 5.0
    [Mergen Telemetri + Ateşleme.brd, Mergen Telemetri + Ateşleme.sch]
2021-08-31 last updates was completed, Ready for flying
    [Adafruit BMP280 STEMMA QT.brd, Adafruit BMP280 STEMMA QT.sch, Adafruit BMP280.brd, Adafruit BMP280.sch, Grove - Barometer Sensor (BMP280) v1.0.brd, Grove - Barometer Sensor (BMP280) v1.0.sch, Mergen Telemetri + Ateşleme.brd, SparkFun_Artemis_OpenLog.brd]
2021-09-17 Systems are stable
    [Mergen Telemetri + Ateşleme.brd, Mergen Telemetri + Ateşleme.sch]
