Brain-dll/MIDDLE-ALTITUDE-MAIN-SYSTEM-EMBEDDED-/(notices)

Notices in the files:
SOFTWARE/Core/Inc/main.h:
© Copyright (c) 2021 STMicroelectronics.
All rights reserved.
This software component is licensed by ST under BSD 3-Clause license,
the "License"; You may not use this file except in compliance with the
License. You may obtain a copy of the License at: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
(C) COPYRIGHT STMicroelectronics *****END OF FILE
parts and their libraries:
SparkFun-Fuses: Licensing: Creative Commons ShareAlike 4.0 International - https://creativecommons.org/licenses/by-sa/4.0
Wurth_EMC Components_WE-TVSP: Copyright: Würth Elektronik
STM32F302C8T6: COPYRIGHT: Copyright (C) 2018 Accelerated Designs. All rights reserved
